ivofrolov/MIDICLK/hardware/Panel.FCStd

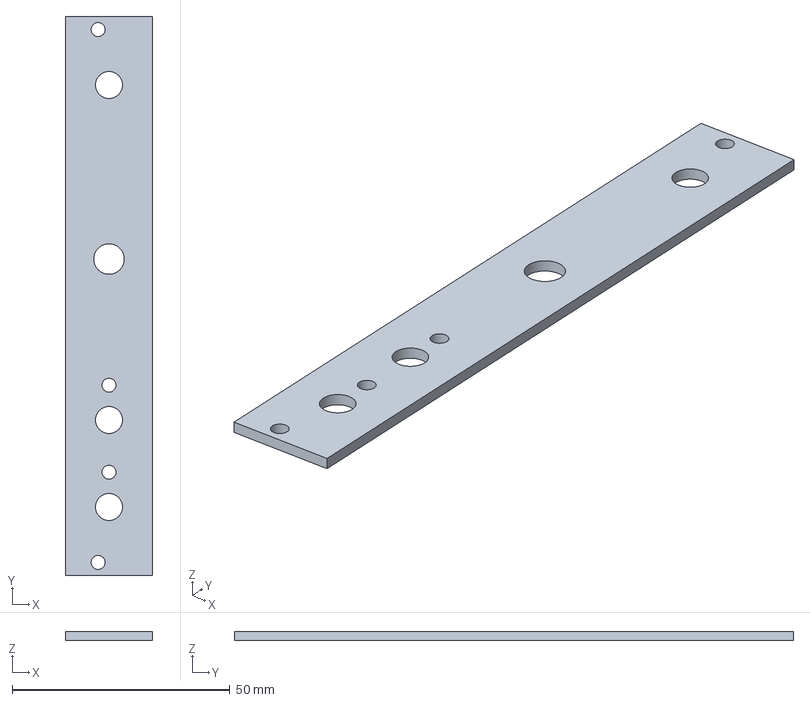
[picture p1: CAD file, 2025-10-13]
hardware/Panel.FCStd
20.0 x 128.5 x 2.00 mm
