ivofrolov/MIDICLK/hardware/MIDICLK.kicad_pcb

## KiCad design hardware/MIDICLK.kicad_pcb (2025-10-13)

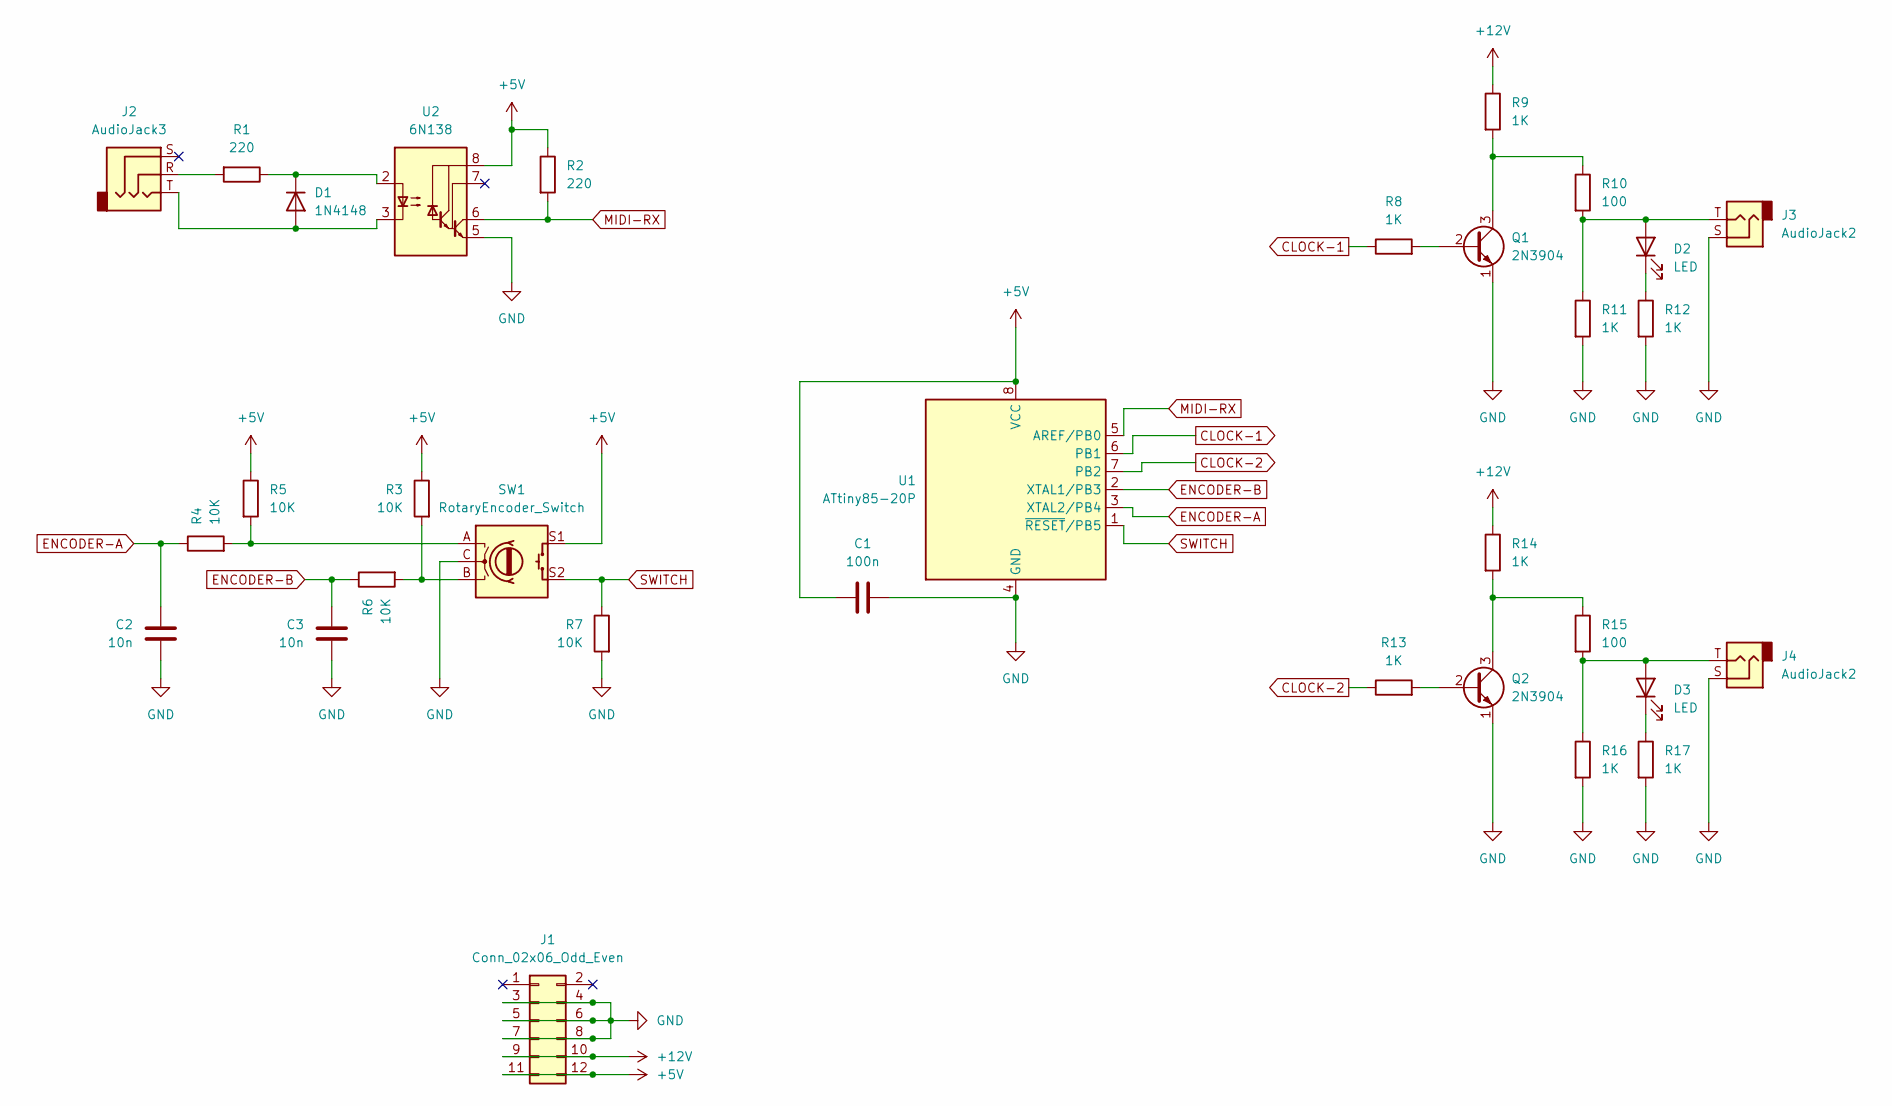
[picture p2: schematic MIDICLK.kicad_sch]

Parts:
C1: 100n; C_Disc_D5.0mm_W2.5mm_P5.00mm
C2, C3: 10n; C_Disc_D5.0mm_W2.5mm_P5.00mm
D1: 1N4148; D_DO-35_SOD27_P7.62mm_Horizontal
D2, D3: LED; LED_D3.0mm
J1: Conn_02x06_Odd_Even; IDC-Header_2x06_P2.54mm_Vertical
J2: AudioJack3; Jack_3.5mm_QingPu_WQP-PJ301CM_Vertical
J3, J4: AudioJack2; Jack_3.5mm_QingPu_WQP-PJ301M-12_Vertical
Q1, Q2: 2N3904; TO-92_Inline
R1, R2: 220; R_Axial_DIN0207_L6.3mm_D2.5mm_P2.54mm_Vertical
R3, R4, R5, R6, R7: 10K; R_Axial_DIN0207_L6.3mm_D2.5mm_P2.54mm_Vertical
R8, R9, R11, R12, R13, R14, R16, R17: 1K; R_Axial_DIN0207_L6.3mm_D2.5mm_P2.54mm_Vertical
R10, R15: 100; R_Axial_DIN0207_L6.3mm_D2.5mm_P2.54mm_Vertical
SW1: RotaryEncoder_Switch; RotaryEncoder_Alps_EC11E-Switch_Vertical_H20mm
U1: ATtiny85-20P; DIP-8_W7.62mm_Socket
U2: 6N138; DIP-8_W7.62mm_Socket

Connections:
+5V: C1.1, J1.11, J1.12, R2.1, R3.1, R5.1, SW1.S1, U1.8 (VCC), U2.8 (VCC)
+12V: J1.9, J1.10, R9.1, R14.1
CLOCK-1: R8.1, U1.6 (PB1)
CLOCK-2: R13.1, U1.7 (PB2)
ENCODER-A: C2.1, R4.1, U1.3 (XTAL2/PB4)
ENCODER-B: C3.1, R6.1, U1.2 (XTAL1/PB3)
GND: C1.2, C2.2, C3.2, J1.3, J1.4, J1.5, J1.6, J1.7, J1.8, J3.S, J4.S, Q1.1 (E), Q2.1 (E), R7.2, R11.2, R12.2, R16.2, R17.2, SW1.C, U1.4 (GND), U2.5 (GND)
MIDI-RX: R2.2, U1.5 (AREF/PB0), U2.6 (VO2)
unnamed: D1.2 (A), J2.T, U2.3 (C2)
unnamed: D1.1 (K), R1.1, U2.2 (C1)
unnamed: D2.2 (A), J3.T, R10.2, R11.1
unnamed: D2.1 (K), R12.1
unnamed: D3.2 (A), J4.T, R15.2, R16.1
unnamed: D3.1 (K), R17.1
unnamed: J2.R, R1.2
unnamed: Q1.2 (B), R8.2
unnamed: Q1.3 (C), R9.2, R10.1
unnamed: Q2.2 (B), R13.2
unnamed: Q2.3 (C), R14.2, R15.1
unnamed: R3.2, R6.2, SW1.B
unnamed: R4.2, R5.2, SW1.A
SWITCH: R7.1, SW1.S2, U1.1 (~RESET/PB5)

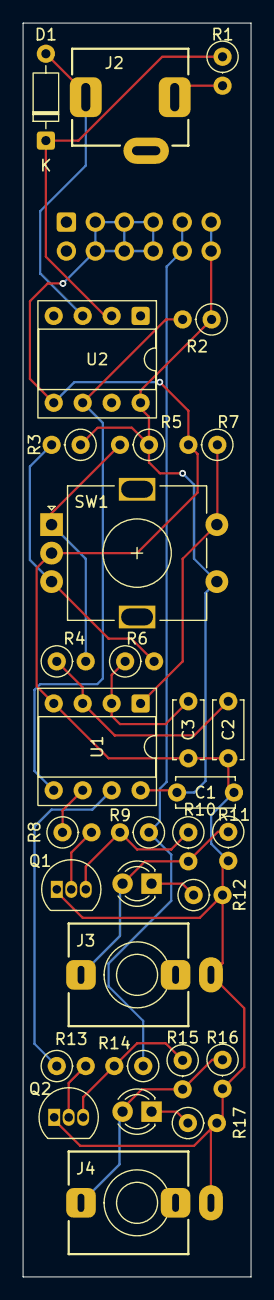
[picture p3: board MIDICLK.kicad_pcb from above]

Board: 2 copper layers, 20.0 x 110.0 mm, 32 parts (1 on the bottom side), 22 nets.
