ivofrolov/MIDICLK/(commit log)

2025-09-02 Initial commit (work in progress)
    [MIDICLK.kicad_pcb, MIDICLK.kicad_sch]
2025-09-07 Quick fix protoboard layout
    [MIDICLK.kicad_sch]
2025-09-09 Invert output pins signal
    [main.c]
2025-09-09 Assign footprints to components
    [MIDICLK.kicad_sch]
2025-09-11 Make PCB
    [MIDICLK.kicad_pcb, MIDICLK.kicad_sch]
2025-10-13 Add panel
    [MIDICLK.kicad_pcb, Panel.FCStd]
2026-06-14 Switch to Makefile build
